AndreCox/OKMR_BMS/local_libs/3d/NVMFS5C430NAFT1G-YE.stp

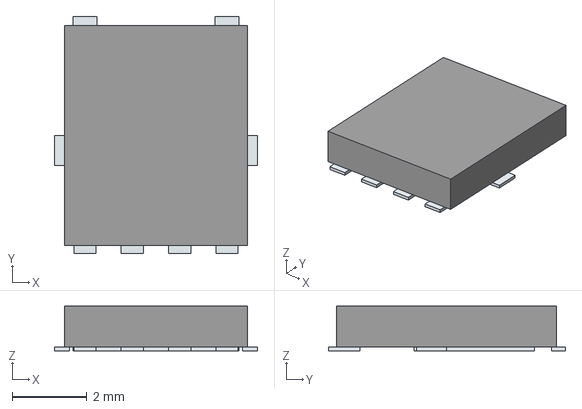
[picture p1: CAD file, 2026-02-22]
local_libs/3d/NVMFS5C430NAFT1G-YE.stp
5.45 x 6.37 x 1.20 mm
Pins
