AndreCox/OKMR_BMS/local_libs/3d/MMBT5401-7-F.stp

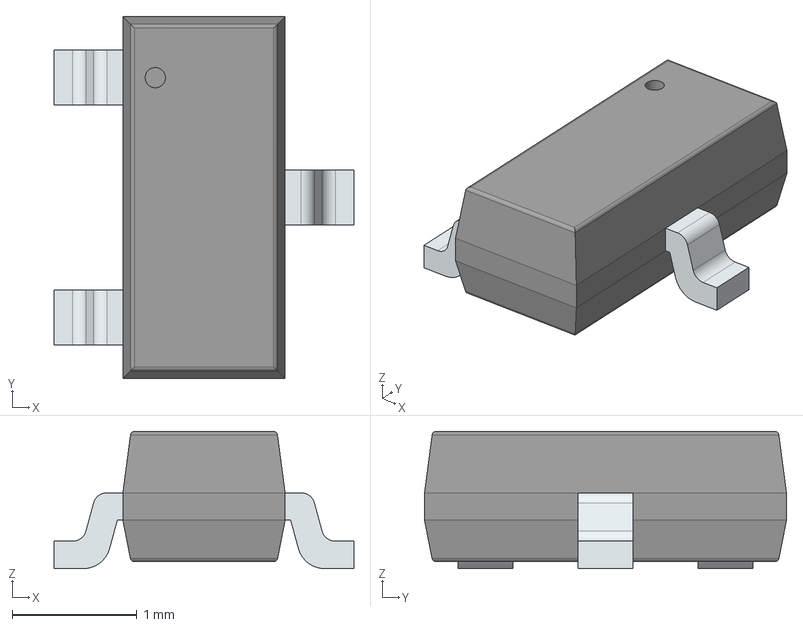
[picture p2: CAD file, 2026-02-22]
local_libs/3d/MMBT5401-7-F.stp
2.40 x 2.90 x 1.10 mm
PinsArrayL
FilletPinR
