AndreCox/OKMR_BMS/local_libs/3d/Midi Fuse 40A.step

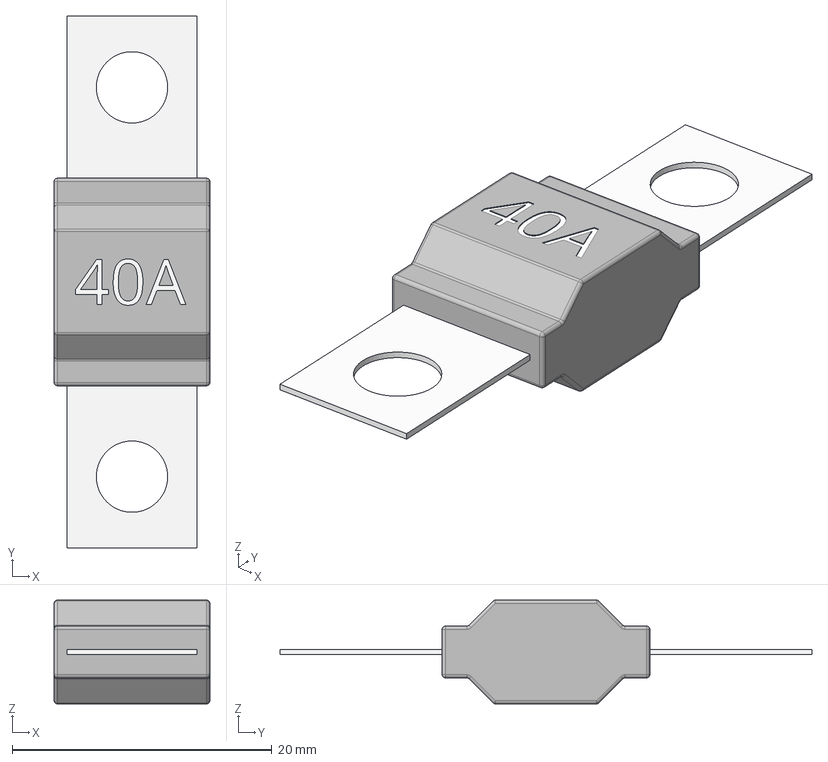
[picture p3: CAD file, 2026-02-22]
local_libs/3d/Midi Fuse 40A.step
12.0 x 41.0 x 8.00 mm
