AndreCox/OKMR_BMS/local_libs/3d/WRB1203S-3WR2.stp

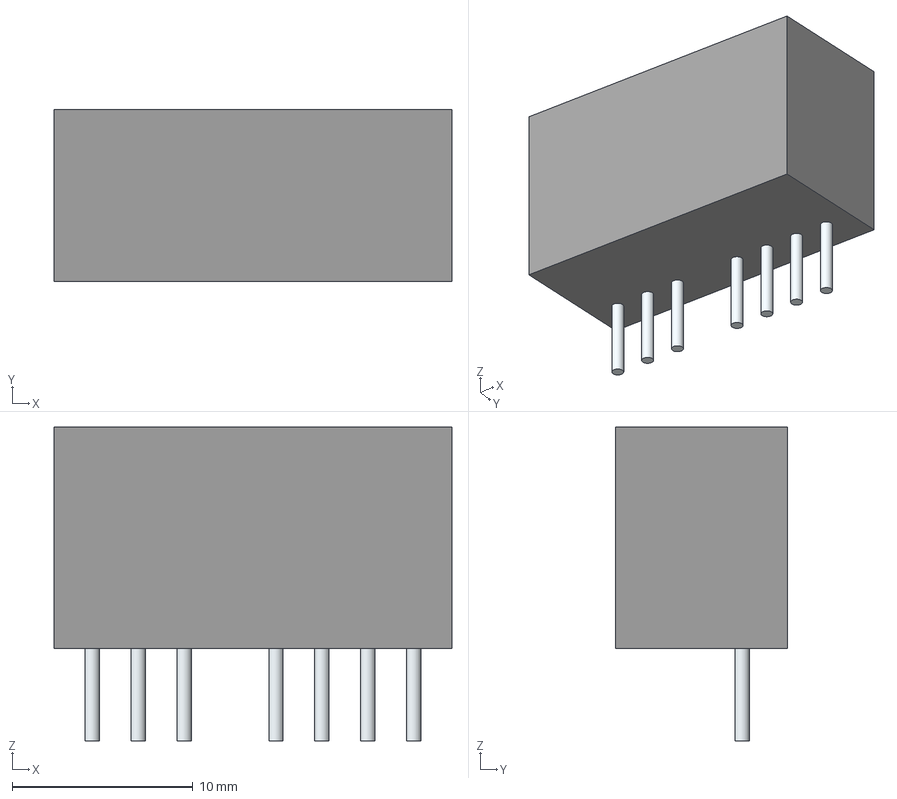
[picture p4: CAD file, 2026-02-22]
local_libs/3d/WRB1203S-3WR2.stp
22.0 x 9.50 x 17.4 mm
Leads
