AndreCox/OKMR_BMS/local_libs/3d/WSK1216L2000FEA.stp

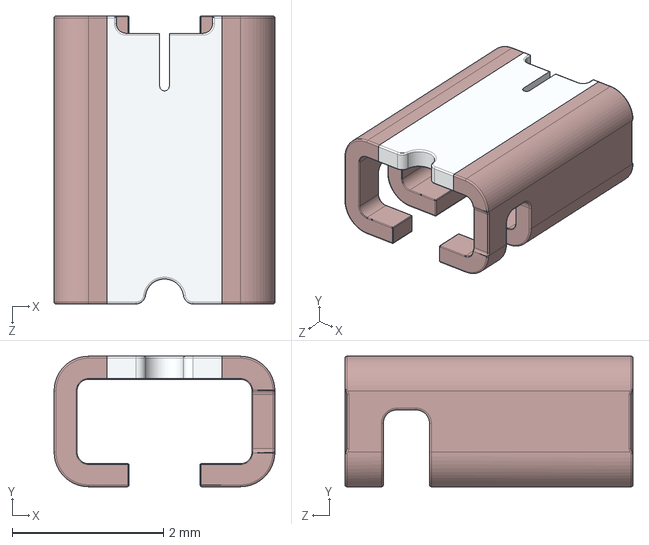
[picture p5: CAD file, 2026-02-22]
local_libs/3d/WSK1216L2000FEA.stp
2.92 x 1.73 x 3.81 mm
WSK1216-L5_element - Copy
WSK1216-L5_terminals - Copy
