AndreCox/OKMR_BMS/local_libs/3d/BQ7694202PFBR.stp

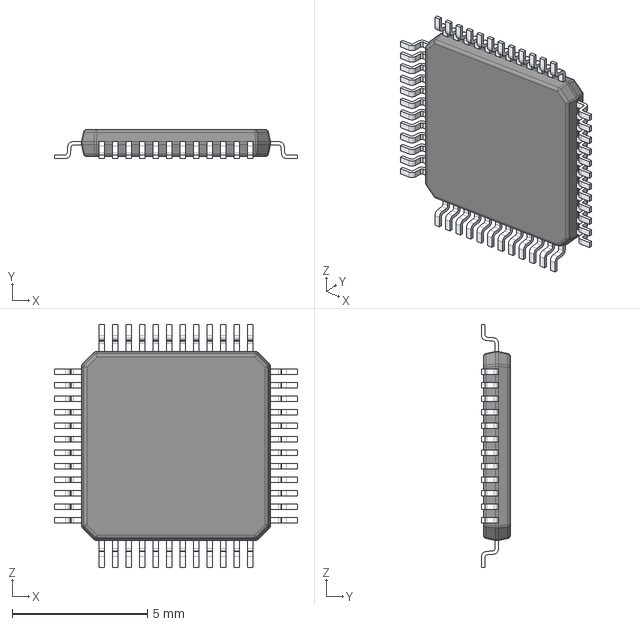
[picture p6: CAD file, 2026-02-22]
local_libs/3d/BQ7694202PFBR.stp
9.00 x 1.07 x 9.00 mm
BODY_VBC48A
LEAD_VBC48A x 48
