AndreCox/OKMR_BMS/(commit log)

2026-02-22 Update FETs
    [power_fets.kicad_sch]
2026-02-23 PCB Layout changes
    [bms_okmr.kicad_pcb, bms_okmr.kicad_sch, power_fets.kicad_sch]
2026-02-24 Added Controller
    [bms_okmr.kicad_pcb, bms_okmr.kicad_sch, controller.kicad_sch]
